YodaCh96/Snake/AP3_Software_04.docx

# Snake The Game

Entwicklung eines Snake-spiels basierend auf Arduino

Verantwortlich: Reindl Dominik, Abreu Diogo, Ioannis Christodoulakis
Arbeitspaket: Software (AP3)
Revision: A
Datum: 28.06.2017
Temperatur: 23.9°C

# 1 Zusammenfassung

In diesem Dokument geht es um das 3. Arbeitspaket des Projektes «Snake the game». Nachdem wir uns schon im «AP-2 Hardware» mit der Software für das Testen der Hardware befasst haben, konnten wir nun das gelernte umsetzen und eine Ausgangslogik schreiben. Die Spiellogik selbst wurde von unserem Informatiker Kollegen, Herr Eggenberger entwickelt. Wir mussten lediglich die Ausgangslogik für das richtige ausschreiben des Arrays übernehmen.

# 2 Ziel des Arbeitspaketes

In diesem Arbeitspaket ist das Ziel, eine funktionsfähige Software zu haben, welche es uns ermöglicht mit unserer Hardware das Spiel «Snake» zu spielen. Dafür müssen wir für die Spiellogik, die von unserem Informatiker Kollegen geschrieben wurde, eine Ausleselogik erstellen welche die Spiellogik auf das von uns gefertigte Shield überträgt.

# 3 Vorstudie

## 3.1 Darstellung auf LED-Matrix korrigiert

### 3.1.1 Problemstellung

Für die Vorstudie haben wir uns damit beschäftigt, eine gleichmässig und korrekt beleuchtete Matrix hinzubekommen. Das Problem war, dass die vorherige Reihenfarbe, aufgrund unserer Testsoftware von AP-2, immer nachleuchten.
Wir haben unser Code welchen wir im AP-2 geschrieben haben, nochmals genau angeschaut, ein Zeitdiagramm geschrieben und folgendes festgestellt.

### 3.1.2 Zeitdiagramm

Nach dem Erstellen eines Zeit Diagramms war uns der Fehler bewusst.

Die roten Markierungen verbinden die zwei Ausgänge ShStPinS und StorePin. Diese müssen zeitgleich ausgegeben werden. Da der erste Ausgang zuständig ist, dass eine neue Zeile angezeigt wird und der zweite Ausgang zuständig für das Ausgeben der neuen 16Bit für die Zeile, müssen diese Zeitgleich von LOW auf HIGH gestellt werden. Es ist sehr wichtig die Zeiten richtig im Griff zu haben. Ist zwischen diesen beiden Befehlen auch nur 1ms Verzögerung, wird auf der vorherigen / nachherigen Reihe die angrenzende Reihe schwach angezeigt.

### 3.1.3 Struktogramme

Bevor wir den neuen Code geschrieben haben, haben wir noch ein Struktogramm geschrieben. Mit diesem ist es ebenfalls einfacher die Übersicht zu behalten.

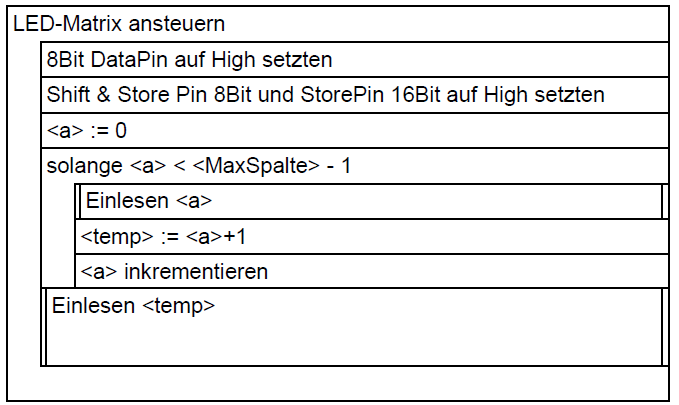
[picture p11: figure]

Dies ist das Haupt Struktogramm für die Ausleselogik

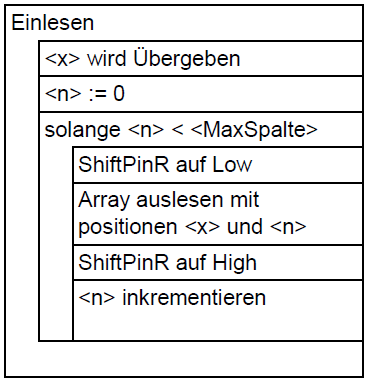
[picture p12: figure]

Hier ist das Struktogramm für das Unterprogramm Einlesen.

### 3.1.4 Lösungsweg

Nach dem wir eine Übersicht geschaffen haben, konnten wir sehen, dass der Fehler beim Ansteuern der beiden Ausgänge StorePin 16Bit und ShStPin 8Bit geschieht. Bei unserer fehlerhaften Programmierung ist eine sehr geringe Zeitverzögerung zwischen der beiden Ausgänge, die eigentlich gleichzeitig auf HIGH wechseln sollten.
Um dieses Problem zu beheben haben wir uns als erstes informiert, wie man bei unserem Zielsystem (Arduino) mehrere Ausgänge gleichzeitig ansteuern kann.
Nach der Recherche haben wir uns für die Portmanipulation entschieden. Dies hat den Vorteil das der Fehler per Software korrigiert werden kann. So muss nichts an der Hardware verändert werden.

Nun haben wir anhand der Struktogramme, Zeitplanung und der Portmanipulation ein neues Programm erstellt.

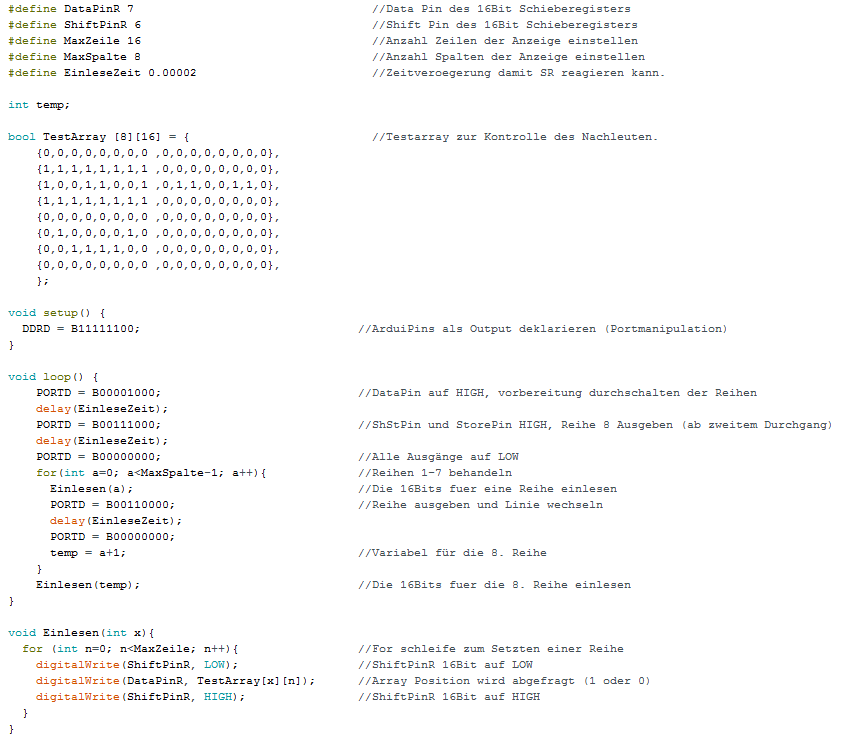
[picture p13: figure]

### 3.1.5 Programmcode

### 3.1.6 Test Darstellung LED-Matrix

Als letztes müssen wir nun unsere Idee, welche wir umgesetzt haben, auch testen. Für den Test haben wir mit Hilfe eines vorgegebenen Arrays ein „Gesicht“ anzeigen lassen.
Das Gesicht hat wie Gewünscht geleuchtet und nun konnte kein Nachleuchten mehr entdeckt werden. Es leuchten auch überall die richtigen LEDs. Somit ist dieses Problem gelöst.

## 3.2 Array umschreiben

### 3.2.1 Problemstellung

Wir haben mit unserem Informatiker folgende Datenstruktur für die Schnittstelle festgelegt. Es handelt sich um ein Array welches eine Grösse von 18 x 10 Felder besitzt. Die äusserste Reihe ist jeweils der Rand. Dieser ist lediglich vorhanden, weil so die Programmierung der Spiellogik einfacher war. Danach kommen immer Grüppchen „R / G“ (rote Markierungen). Eine solche Gruppe repräsentiert ein LED-Slot auf der 8x8 LED Matrix. Das „R“ steht für die rote LED und der Buchstabe „G“ für die grüne LED. Dieses Array wiederspiegelt unsere LED-Matrix 8x8 Grün / Rot.
Mithilfe diesem Array wissen wir welche LEDs auf der Matrix brennen müssen. Unsere Auslese-Logik ist dann in der Lage dieses Array auszulesen und auf die Matrix auf dem Shield zu übertragen.

X | X | X | X | X | X | X | X | X | X | X | X | X | X | X | X | X | X
X | R | G | R | G | R | G | R | G | R | G | R | G | R | G | R | G | X
X | R | G | R | G | R | G | R | G | R | G | R | G | R | G | R | G | X
X | R | G | R | G | R | G | R | G | R | G | R | G | R | G | R | G | X
X | R | G | R | G | R | G | R | G | R | G | R | G | R | G | R | G | X
X | R | G | R | G | R | G | R | G | R | G | R | G | R | G | R | G | X
X | R | G | R | G | R | G | R | G | R | G | R | G | R | G | R | G | X
X | R | G | R | G | R | G | R | G | R | G | R | G | R | G | R | G | X
X | R | G | R | G | R | G | R | G | R | G | R | G | R | G | R | G | X
X | X | X | X | X | X | X | X | X | X | X | X | X | X | X | X | X | x

X = Der Rand des Feldes entspricht einer 0.
R = Die roten LEDs.
G = Die grünen LEDs.

Doch durch unsere Hardware ist es gegeben, dass die ersten 8 Ausgänge für rot und die restlichen 8 Ausgänge für grün sind. Gemäss folgender Darstellung:

R | R | R | R | R | R | R | R | G | G | G | G | G | G | G | G
R | R | R | R | R | R | R | R | G | G | G | G | G | G | G | G
R | R | R | R | R | R | R | R | G | G | G | G | G | G | G | G
R | R | R | R | R | R | R | R | G | G | G | G | G | G | G | G
R | R | R | R | R | R | R | R | G | G | G | G | G | G | G | G
R | R | R | R | R | R | R | R | G | G | G | G | G | G | G | G
R | R | R | R | R | R | R | R | G | G | G | G | G | G | G | G
R | R | R | R | R | R | R | R | G | G | G | G | G | G | G | G

Nun sieht man das eine andere Reihenfolge nötig ist, als wir vom Informatiker bekommen. Somit müssen wir uns überlegen, wie wir diese Differenz beheben.

Grob gesagt gibt es nun zwei Lösungsvarianten. Die eine Variante besteht darin, das Array vom Informatiker auf ein neues Array umzuschreiben und das neue Array dann mit der bestehenden Ausleselogik (vom zweiten Arbeitspaket von der Testfälle) bearbeiten.
Die zweite Variante besteht darin, unsere Ausleselogik so anzupassen, dass das Array vom Informatiker nicht in der Reihenfolge, sondern gleich so ausliest, dass zuerst die Daten ausgelesen werden welche benötigt sind. Also zuerst die acht Bit der roten Farbe danach die acht Bit der grünen.

### 3.2.2 Entscheidung

Bei uns ist es wichtig, dass es möglichst wenig Zeit beansprucht für unsere Ausleselogik, da eine schöne Darstellung auf der LED Anzeige eine schnelle Durchlaufzeit voraussetzt. Daher ist die zweite Variante sinnvoller. Somit wollen wir in unserem Code möglichst wenige Schritte machen müssen. Deshalb ist es effizienter das vorhandene Array nach der Reihenfolge welche wir die Bits brauchen auszulesen.

### 3.2.3 Struktogramm

Da wir wissen, wie unsere Ausgangslogik nun funktionieren muss, haben wir den Umständen entsprechend ein neues Struktogramm erstellt.

Als erstes ist hier das Haupt-Struktogramm ersichtlich. Mit dieser Logik kann das 10 x 18 Array von unserem Informatiker ausgelesen und die Informationen auf die LED-Matrix übertragen werden.

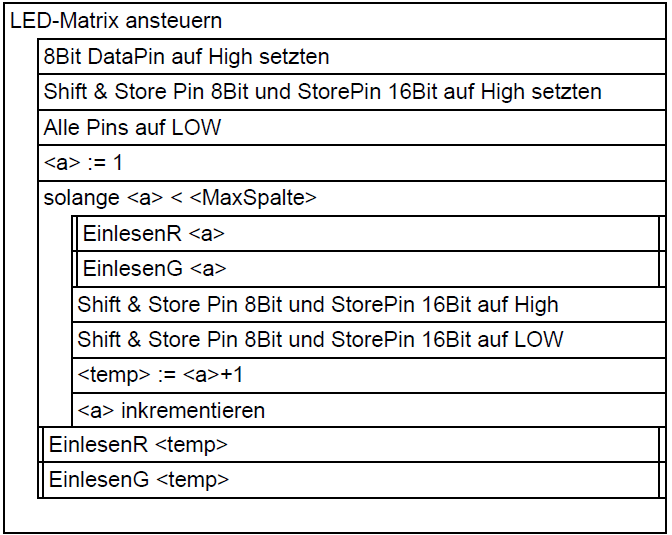
[picture p14: figure]

Hier sind noch die Unterprogramme aufgelistet:

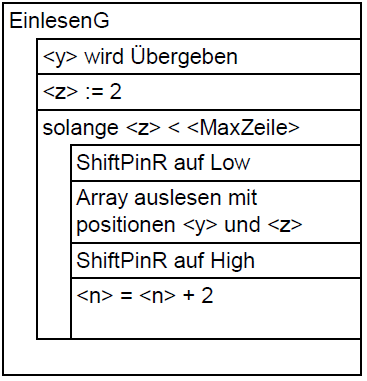
[picture p15: figure]
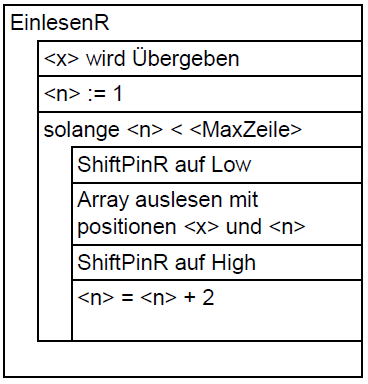
[picture p16: figure]

### 3.2.4 Programmcode

Da wir die Struktogramme erstellt haben, kann nun ein Programm geschrieben werden, welches den neuen Anforderungen entspricht.

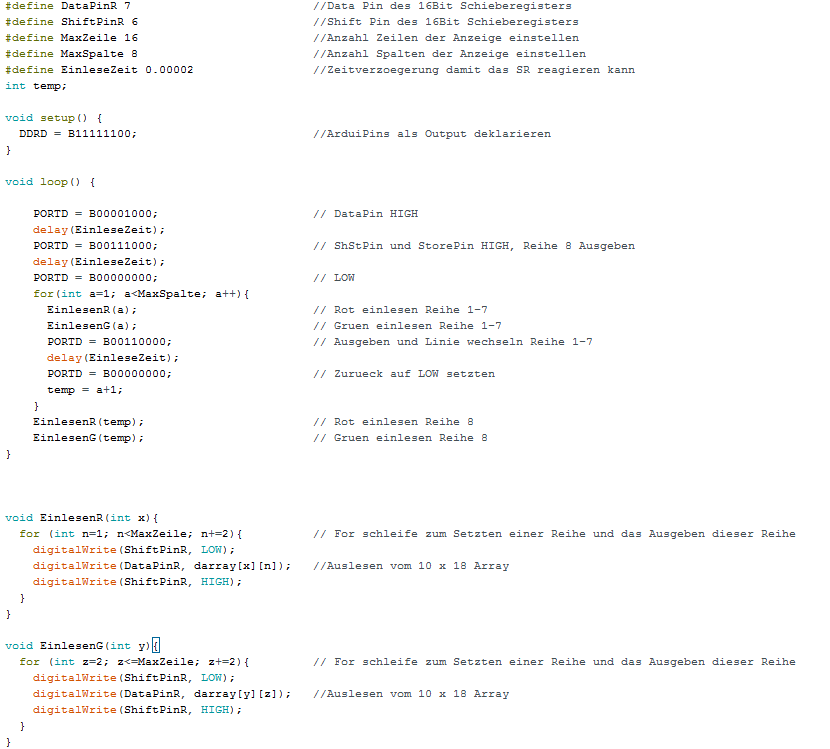
[picture p17: figure]

### 3.2.5 Test Auslesen und Ausgeben von 10 x 18 Array

Für unseren Test haben wir selbst einen 10 x 18 Array erstellt und diesen ausgelesen. Wir haben kontrolliert ob, auf der LED-Matrix ebenfalls das Bild wiedergegeben wird, wie wir es erwarten.
Zu diesem Zweck haben wir je eine Zeile rot und dann eine Zeile grün leuchten lassen und dies über alle Zeilen hinweg.

Als wir das Programm zusammen mit dem Array auf das Arduino geladen haben, konnten wir wie erwartet das gewünschte Muster auf der LED-Anzeige sehen.

Unsere Lösung ist somit funktionsfähig.

# 4 Spiellogik und Ausleselogik zusammenfügen

Wir haben jetzt all unsere Teilprobleme gelöst und können unsere Lösung als Ausleselogik mit der Spiellogik vom Informatiker zusammenfügen.

Da wir selbst im Programmieren erst die Grundkenntnisse beherrschen, haben wir diesen Schritt gleich mit dem Informatiker, Herr Eggenberger, durchgeführt.

## 4.1 Gesamttest Nummer 1

Wir testen die am Anfang definierten Testfälle durch

Testfall | Tatsächliche Reaktion | Ok?
Das Spiel muss am Schluss von unserem Projekt, auf einer 8x8 Matrix mit vier Taster spielbar sein (gemäss Spieldefinition). | Es ist nicht spielbar. Die Spiel und Ausleselogik arbeiten nicht sauber Zusammen | Nein

Da der erste Testfall bereits nicht geklappt hat, müssen die nächsten nicht getestet werden. Als nächstes werden wir den Fehler suchen.

## 4.2 Problematik

Wir analysierten zusammen das Problem, um herauszufinden warum das auf der Anzeige meist ein kurioses Muster angezeigt wird. Beim genaueren Betrachten haben wir einen grundlegenden Fehler entdeckt.
Wir haben ein konzeptionelles Problem. Unsere Hardware ist darauf ausgelegt, dass diese ohne Unterbruch angesteuert wird. Das heisst, dass die Bits für die Darstellung ständig neu übertragen werden müssen. Wir steuern auf einmal immer nur eine Reihe an und schalten dann in hoher Geschwindigkeit die einzelnen acht Reihen um. Dieser Vorgang muss mindestens 20 mal in der Sekunde geschehen damit auf der LED Matrix ein konstantes Bild angezeigt wird.
Das Problem lag nun genau darin, dass von der Spiellogik her unsere Ausleselogik mehrmals aufgerufen wird, aber zwischen den Aufrufen wird die Ausleselogik unterbrochen. So konnte kein schönes Bild dargestellt werden.

## 4.3 Anpassung

Die erste Konsequenz daraus ist, dass der Informatiker, Herr Eggenberger, die Spiellogik umschreibt. Der Code muss die Spiellogik und die Ausleselogik parallel laufen lassen können. Bei diesem Punkt können wir nicht viel mitwirken, da dies unsere Programmierkenntnisse übersteigert. Und das Problem besteht auf Seite der Spiellogik, welche wir nicht erstellt haben.

## 4.4 Spiellogik vom Informatiker

Hier sehen Sie eine Übersicht wie die Spiellogik vom Informatiker aufgebaut ist. Der Gesamtcode ist unter „H:\LL\ELO 2016\Snake_Codes“ zu finden.

## 4.5 Gesamttest Nummer 2

Nun können wir unsere Testfälle nochmal durchgehen.

Testfall | Tatsächliche Reaktion | Ok?
Das Spiel muss am Schluss von unserem Projekt, auf einer 8x8 Matrix mit vier Taster spielbar sein (gemäss Spieldefinition). | Wie erwartet: Schlange steuerbar, Futter essbar, Rand und eigener Schwanz führt zur Niederlage. Punktestand wird angezeigt. | Ok
Falls mehrere Taster auf einmal gedrückt und gehalten werden, soll der letzte gelesene Impuls übernommen werden. | Wir erwartet | Ok
Wenn man nur kurz und ausserhalb von Takt der Schlangenbewegung den Taster betätigt, soll es diese Tasterrichtung speichern und zum Takt ausführen. | Wie erwartet | Ok
Beim Betätigen von mehreren Tastern nacheinander, ausserhalb des Taktes der Schlangenbewegung, soll es den letzten eingegangener Taster Impuls übernehmen. | Wie erwartet | Ok
Falls eine in entgegen gesetzter Richtungstaste geklickt wird (in Bezug auf die Schlangenbewegung), soll es keine Richtungsänderung geben. | Wie erwartet | Ok

# 5 Auswertung

Wir konnten all unsere Einzellösungen realisieren und erfolgreich testen. Die grosse Problematik hatten wir beim Zusammenführen der einzelnen Teillösungen, vor allem mit dem Zusammenführen der Ausleselogik mit der Spielelogik des Informatikers. Da unsere Ausgangslogik ununterbrochen laufen muss, musste der Informatiker eine Lösung finden, damit die Spielelogik mit der Ausleselogik parallel abläuft. Diese Problematik kam davon, dass wir die Schnittstellen zu Beginn des Projekts nicht sauber genug definiert und kommuniziert haben. Die Konsequenz war zwar nicht so schlimm, da der Informatiker eine Lösung gefunden hat. Jedoch hat dieser Fehler unsere Zeitplanung durcheinandergebracht. Wir haben noch Reserven eingebplant, welche dann zur Gesamt Fertigstellung gebraucht werden.

In diesem Arbeitspaket konnten wir viel Wissen über das Programmieren sammeln und selbst erfahren wie wichtig die Definition der Schnittstellen von Beginn an sind.

Auch wenn wir für dieses Arbeitspaket Zeitlich länger gebraucht haben, konnten wir das Projekt wie gewünscht abschliessen. Wir haben ein funktionsfähiges Snake geplant, entwickelt und gefertigt.

# 6 Anhang

## 6.1 Glossar

Arduino / Arduino-Board
Handelsware: Eine bestückte Leiterplatine mit mehreren Schnittstellen (Ein und Ausgänge). Diese kann beliebig via Computer programmiert werden, um flexibel Codes ausführen zu können

Shield
Ein Aufbau auf einer Platine, welche alle nötigen Hardware besitzt. Dies kann als fertiges Element direkt (zum Beispiel bei einem Arduino) aufgesetzt werden.

LED-Slot
Die LED Matrix besteht aus 8 x 8 LED Slots. Also 64 Stück. Jeder dieser Slot besteht aus einem grünen und einem rotem LED.

LED-Matrix
Unsere Anzeige, welche aus 8 x 8 LED Slots besteht.

Portmanipulation
Eine Programmier-Methode beim Arduino. Mit diesen Befehlen können ganze Ports (Gruppen von digitalen / analogen Ein- Ausgänge) angesprochen werden. So können sehr viel genauer und Zeitgleicher Ausgänge angesteuert werden.

# 7 Identifikation

Ort, Datum: Unterschriften:

_________________ _________________ _________________

Diogo Abreu Dominik Reindl

D.R. / D.A. Seite 12 von 12
