YodaCh96/Snake/AP-3 Software/AP3_Software.docx

# Snake The Game

Entwicklung eines Snake-spiels basierend auf Arduino

Verantwortlich: Reindl Dominik, Abreu Diogo, Ioannis Christodoulakis
Arbeitspaket: Software (AP3)
Revision: A
Datum: 30.05.2017
Temperatur: 23.9°C

# 1 Zusammenfassung

In diesem Dokument geht es um das 3. Arbeitspaket des Projektes «Snake the game». Nachdem wir uns schon im «AP-2 Hardware» mit der Software für das Testen der Hardware befasst haben, konnten wir nun das gelernte umsetzen und eine Ausgangslogik schreiben. Die Spiellogik selbst wurde von unserem Informatiker Kollegen, Herr Eggenberger entwickelt, wir mussten nur noch die Ausgangslogik für das richtige ausschreiben des Arrays übernehmen.

# 2 Ziel des Arbeitspaketes

In diesem Arbeitspaket ist das Ziel, eine funktionsfähige Software zu haben, welche es uns ermöglicht mit unserer Hardware das Spiel «Snake» zu spielen. Dafür müssen wir für die Spiellogik, die von unserem Informatiker Kollegen geschrieben wurde, eine Ausgangslogik erstellen welche die Spiellogik auf unser Shield überträgt.

# 3 Vorstudie

## 3.1 Darstellung auf LED-Matrix korrigiert

### 3.1.1 Problemstellung

Für die Vorstudie haben wir uns damit beschäftigt, eine gleichmässig beleuchtete Matrix hinzubekommen. Das Problem war, dass die vorherige Reihenfarbe, aufgrund unserer Methode für die Beschaltung der einzelnen Reihen, immer nachleuchten.
Wir haben unser Code welchen wir im Arbeitspaket 2 geschrieben haben nochmals genau angeschaut.

### 3.1.2 Zeitdiagramm

Nach dem Erstellen eines Zeit Diagramms war uns der Fehler bewusst.

Die roten Markierungen verbinden die zwei Ausgänge ShStPinS und StorePin. Diese müssen zeitgleich ausgegeben werden. Da der erste Ausgang zuständig ist, dass eine neue Reihe angezeigt wird und der zweite Ausgang zuständig für das Ausgeben der neuen 16Bit für die Reihe, müssen diese Zeitgleich von LOW auf HIGH gestellt werden. Ist zwischen diesen beiden Befehlen auch nur 1ms Verzögerung, wird auf der vorherigen / nachherigen Reihe die angrenzende Reihe schwach angezeigt.

### 3.1.3 Struktogramme

Bevor wir den neuen Code geschrieben haben, haben wir noch ein Struktogramm geschrieben. Mit diesem ist es ebenfalls einfach die Übersicht zu behalten.


Dies ist das Haupt Struktogramm für die Ausleselogik


Hier ist das Struktogramm für das Unterprogramm Einlesen.

### 3.1.4 Lösungsweg

Nach dem wir eine Übersicht geschaffen haben, konnten wir sehen, dass der Fehler beim Ansteuern der beiden Ausgänge StorePin 16Bit und ShStPin 8Bit geschieht. Da wir bei unserer momentanen Programmierung eine sehr geringe Zeitverzögerung zwischen dem HIGH stellen der beiden Ausgänge haben.
Um dieses Problem zu beheben haben wir uns als erstes Informiert wie man bei unserem Zielsystem (Arduino) mehrere Ausgänge gleichzeitig ansteuern kann.
Nach der Recherche haben wir uns für die Port-Manipulation entschieden. Dies hat den Vorteil das der Fehler per Software korrigiert werden kann. So muss nichts an der Hardware verändert werden.

Nun haben wir anhand der Struktogramme, Zeitplanung und der Portmanipulation ein neues Programm erstellt.


### 3.1.5 Programmcode

### 3.1.6 Test Darstellung LED-Matrix

Als letztes müssen wir unsere Idee, welche wir umgesetzt haben, testen. Für den Test haben wir ein „Gesicht“ anzeigen lassen. Nun konnte kein Nachleuchten mehr entdeckt werden. Es leuchten auch überall die richtigen LEDs. Somit ist dieses Problem gelöst.

## 3.2 Array umschreiben

### 3.2.1 Problemstellung

Wir haben mit unserem Informatiker folgende Datenstruktur für die Schnittstelle festgelegt. Es handelt sich um ein Array welches eine Grösse von 18 x 10 Felder besitzt. Die Äusserste Reihe ist jeweils der Rand. Dieser ist lediglich vorhanden, weil so die Programmierung der Spiellogik einfach war. Danach kommen immer Grüppchen „R / G“ (rote Markierungen). Eine solche Gruppe repräsentiert ein LED-Slot auf der 8x8 LED Matrix. Das „R“ steht für das rote LED und der Buchstabe „G“ für das grüne LED. Dieses Array wiederspiegelt unsere LED-Matrix 8x8 Grün / Rot.
Mithilfe diesem Array wissen wir welche LEDs auf der Matrix brennen müssen. Unsere Auslese-Logik ist dann in der Lage dieses Array auszulesen und auf die Matrix zu übertragen.

X | X | X | X | X | X | X | X | X | X | X | X | X | X | X | X | X | X
X | R | G | R | G | R | G | R | G | R | G | R | G | R | G | R | G | X
X | R | G | R | G | R | G | R | G | R | G | R | G | R | G | R | G | X
X | R | G | R | G | R | G | R | G | R | G | R | G | R | G | R | G | X
X | R | G | R | G | R | G | R | G | R | G | R | G | R | G | R | G | X
X | R | G | R | G | R | G | R | G | R | G | R | G | R | G | R | G | X
X | R | G | R | G | R | G | R | G | R | G | R | G | R | G | R | G | X
X | R | G | R | G | R | G | R | G | R | G | R | G | R | G | R | G | X
X | R | G | R | G | R | G | R | G | R | G | R | G | R | G | R | G | X
X | X | X | X | X | X | X | X | X | X | X | X | X | X | X | X | X | x

X = Der Rand des Feldes entspricht einer 0.
R = Die roten LEDs.
G = Die grünen LEDs.

Doch durch unsere Hardware ist es gegeben, dass die ersten 8 Ausgänge für rot und die restlichen 8 Ausgänge für grün sind. Gemäss folgender Darstellung.

R | R | R | R | R | R | R | R | G | G | G | G | G | G | G | G
R | R | R | R | R | R | R | R | G | G | G | G | G | G | G | G
R | R | R | R | R | R | R | R | G | G | G | G | G | G | G | G
R | R | R | R | R | R | R | R | G | G | G | G | G | G | G | G
R | R | R | R | R | R | R | R | G | G | G | G | G | G | G | G
R | R | R | R | R | R | R | R | G | G | G | G | G | G | G | G
R | R | R | R | R | R | R | R | G | G | G | G | G | G | G | G
R | R | R | R | R | R | R | R | G | G | G | G | G | G | G | G

Nun sieht man das eine andere Reihenfolge nötig ist, als wir vom Informatiker bekommen. Somit müssen wir uns überlegen, wie wir diese Differenz beheben.

Grob gesagt gibt es nun zwei Lösungsvarianten. Die eine Variante besteht darin das Array vom Informatiker umzuschreiben auf ein neues Array und das neue Array dann mit der bestehenden Ausleselogik (Vom zweiten Arbeitspaket von der Testfälle) bearbeiten.
Die Zweite Variante besteht darin, unsere Ausleselogik so anzupassen dass das Array vom Informatiker nicht in der Reihenfolge sondern gleich so ausliest das zuerst die Daten ausgelesen werden welche benötigt sind. Also zuerst die acht Bit der roten Farbe danach die acht Bit der grünen.

### 3.2.2 Entscheidung

Bei uns ist es wichtig das es möglichst wenig Zeit beansprucht für unsere Ausleselogik. Da eine schöne Darstellung auf der LED Anzeige eine schnelle Durchlaufzeit voraussetzt, wollen wir möglichst wenig Schritte machen müssen in unserem Code. So ist es effizienter das Vorhandene Array nach der Reihenfolge welche wir die Bits brauchen auszulesen. So ist ein schreiben und dann wieder auslesen von einem neuen Array verhindert. Der Zugriff auf Array ist eine im Vergleich zeitaufwändige Option.

### 3.2.3 Struktogramm

So haben wir zu den Umständen entsprechend ein neues Struktogramm erstellt. Da wir wissen, wie unsere Ausgangslogik nun funktionieren muss.

Als erstes hier das Haupt-Struktogramm. Mit dieser Logik kann das 10 x 18 Array von unserem Informatiker ausgelesen und die Informationen auf die LED-Matrix übertragen werden.


Hier sind noch die Unterprogramme aufgelistet:


### 3.2.4 Programmcode

Da wir die Struktogramme erstellt haben, kann nun ein Programm geschrieben werden, welches den neuen Anforderungen entspricht.

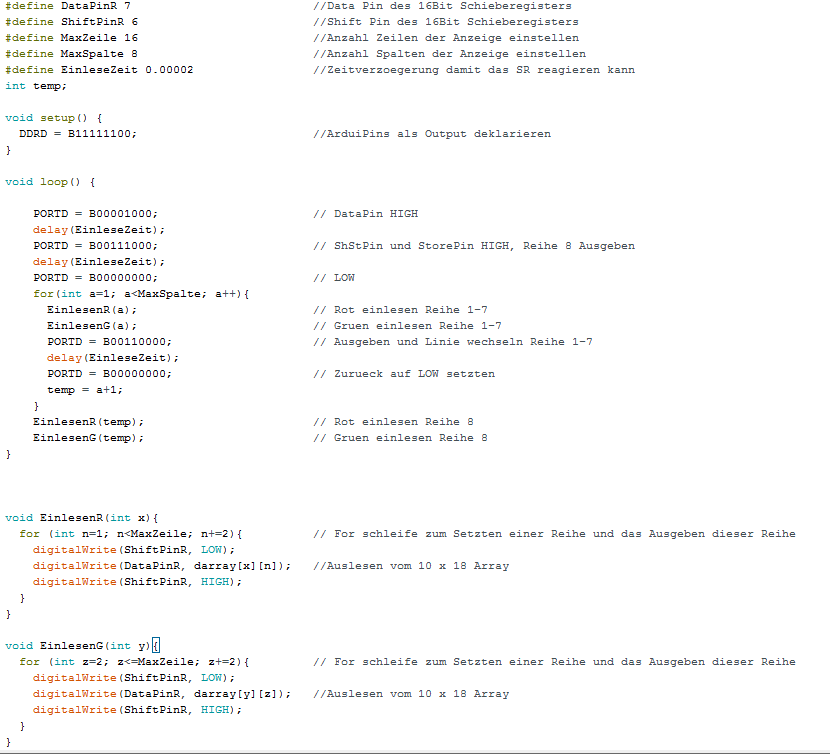
[picture p18: figure]

### 3.2.5 Test Auslesen und Ausgeben von 10 x 18 Array

Für unseren Test haben wir selbst eine 10 x 18 Array erstellt und dieses ausgelesen. Wir haben kontrolliert ob, auf der LED-Matrix ebenfalls das Bild wiedergegeben wird, wie wir es erwarten.
Zu diesem Zweck haben wir je eine Zeile rot und dann eine Zeile grün leuchten lassen und dies über alle Zeilen hinweg.

Als wir das Programm zusammen mit dem Array auf das Arduino geladen haben, konnten wir wie erwartet das gewünschte Muster auf der LED-Anzeige sehen.

Unsere Lösung ist somit funktionsfähig.

# 4 Spiellogik und Ausleselogik zusammenfügen

# 5 Test des Snake-Spiels

Testfälle vom Anfang des Projektes anschauen

## 5.1 Testfälle

Testschritt | Erwartete Reaktion | Tatsächliche Reaktion | Wunsch / Pflicht
Programmcode für LED durchlaufen lassen. | Eine LED Reihe nach der anderen sollten anfangen zu leuchten und wieder ausgehen. | Es leuchten keine LEDs. | Pflicht
Taster-Funktionen testen: Alle vier Tasten werden einzeln durchgeklickt. | Bei jeder Taster muss ein anderes Muster auf der LED Anzeige aufleuchten. | Die Taster ergeben keine Reaktion. | Pflicht
Gibt es einen Piezo Buzzer für Soundeffekte, sowie ein Potentiometer (Poti) für die Lautstärke? | Beim Testen gibt es Töne von unsere Shield aus. Die Lautstärke ist einstellbar mit einem Poti. | Dieses Wunschziel haben wir aus Zeitgründen nicht erreicht. | Wunsch
Wurde ein Gehäuse definiert für unsere Hardware? | Als Ergebnis haben wir einen Plan von einem Gehäuse. | Dieses Wunschziel haben wir aus Zeitgründen nicht erreicht. | Wunsch

# 6 Korrekturen

## 6.1 Fehlersuche

Leider konnten wir nicht unser gewünschtes Ergebnis auf Anhieb erreichen. Nun müssen wir Systematisch den Fehler herausfinden.

Unsere erste Überlegung war, ob der Fehler auf Seite der Software oder Hardware liegt. Bei der Software konnten wir schnell mithilfe der «Serial» Funktion von Arduino herausfinden das die Software wie gewünscht durchläuft.

Deswegen haben wir als nächstes unser Shield genauer angeschaut. Hier haben wir die einzelnen Komponenten durchgetestet. Dafür haben wir mit der LED-Matrix angefangen. Dies erschien uns ein guter Anfang, da überhaupt kein LED geleuchtet hat. Wir haben mithilfe eines Speisegerät und einem Vorwiderstand die LEDs manuell einzeln Angesteuert. Da haben wir festgestellt das die Anode und Katode vertauscht sind. Somit wurden bei unserem Aufbau alle LEDs auf der Matrix in Sperrrichtung betrieben. Der Fehler schlich sich ein, da wir unseren Fokus viel zu wenig darauf hatten, dass es von diesem LED Matrix mit «Reihe Kathode» sowie «Reihe Anode» Ausführung gibt. So ist es gekommen, dass wir das Datenblatt mit «Reihe Kathode» beim Erstellen der Shield hatten. Doch die Überlegung unseren Shield haben wir auf der «Reihe Anode» aufgebaut.
Bei der Vorstudie wurde diese Problematik leider zu wenig genau dokumentiert.

## 6.2 Entscheid Korrekturen

## 6.3 Programmcode

## 6.4 Test des Snake-Spiels

# 7 Auswertung

Beim zweiten Durchgang konnten wie in unseren Zielen definiert, ein funktionsfähiges Shield herstellen. Wir haben dieses Arbeitspaket vorgezogen. Da Herr Eggenberger (Informatik-Ressource) mit der Spiellogik in Verzug kam. Für das Arbeitspaket Software bräuchten wir jedoch die Software von Herr Eggenberger.

Wir haben nicht von Anfang an sauber den Tatbestand dokumentiert und aufgezeigt. So kam es in diesem Arbeitspaket zu einem Fehler, welcher dazu führte, dass wir unser Shield ein zweites Mal löten mussten. So sind wir in unserem Zeitplan in den Verzug gekommen. Wir konnten so ebenfalls nur die Pflichtziele erfüllen. Falls zum Schluss beim Arbeitspaket «Endprodukt» genug Zeit für Verbesserungen bleibt, werden wir noch die Wunschziele einfügen.

Nach dem zweiten Testlauf haben wir bemerkt, dass bei der Anzeige auf dem Display einige LED Punkte nicht sauber angesteuert werden. Doch wir konnten ausschliessen, dass es von der Hardware aus kommt. So werden wir beim AP Software für dieses Problem noch eine Vorstudie durchführen.

# 8 Anhang

## 8.1 Glossar

Arduino / Arduino-Board
Handelsware: Eine bestückte Leiterplatine mit mehreren Schnittstellen (Ein und Ausgänge). Diese kann beliebig via Computer programmiert werden, um flexibel Codes ausführen zu können

Shield
Ein Aufbau auf einer Platine, welche alle nötigen Hardware besitzt. Dies kann als fertiges Element direkt (zum Beispiel bei einem Arduino) aufgesetzt werden.

Bedienelemente
Komponenten, welche effektiv zum Spielen benötigt werden. Dazu gehören LED Matrix, Bedientaster sowie der Ein- / Austaster.

Serial
Dies ist eine Funktion beim Arduino. Mit diesem Befehl kann in einem Fenster im Computer je nach Arbeitsschritt andere Texte / Werte anzeigen lassen. Dies ist sehr nützlich um die Funktionsfähigkeit einer Software zu überprüfen.

LED-Slot
Die LED Matrix besteht aus 8 x 8 LED Slots. Also 64 Stück. Jeder dieser Slot besteht aus einem grünen und rotem LED.

## 8.2 Datenblätter

## 8.3 Programmcode

# 9 Identifikation

Ort, Datum: Unterschriften:

_________________ _________________ _________________

Diogo Abreu Dominik Reindl

D.R. / D.A. Seite 6 von 13
