YodaCh96/Snake/LED Matrix Schema.docx

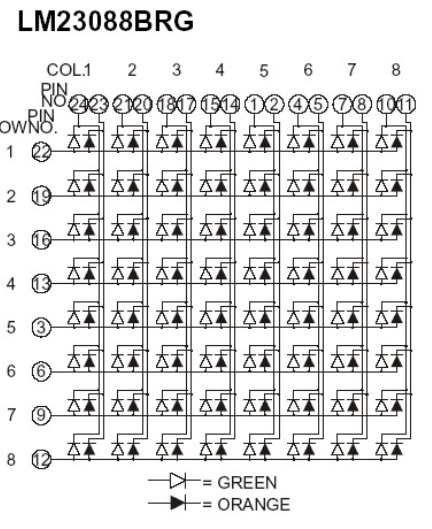
[picture p25: figure]
