YodaCh96/Snake/AP-1 Konzept/Schema_Schnittstellen.docx

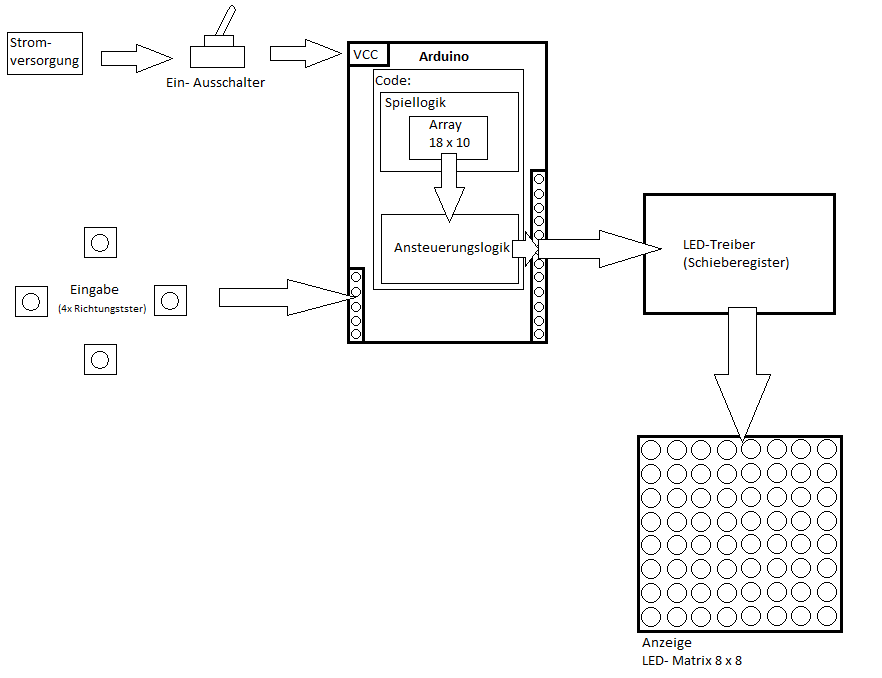
[picture p26: figure]

4 x Richtungstaster
