YodaCh96/Snake/Administration/Projekt Status report.pdf

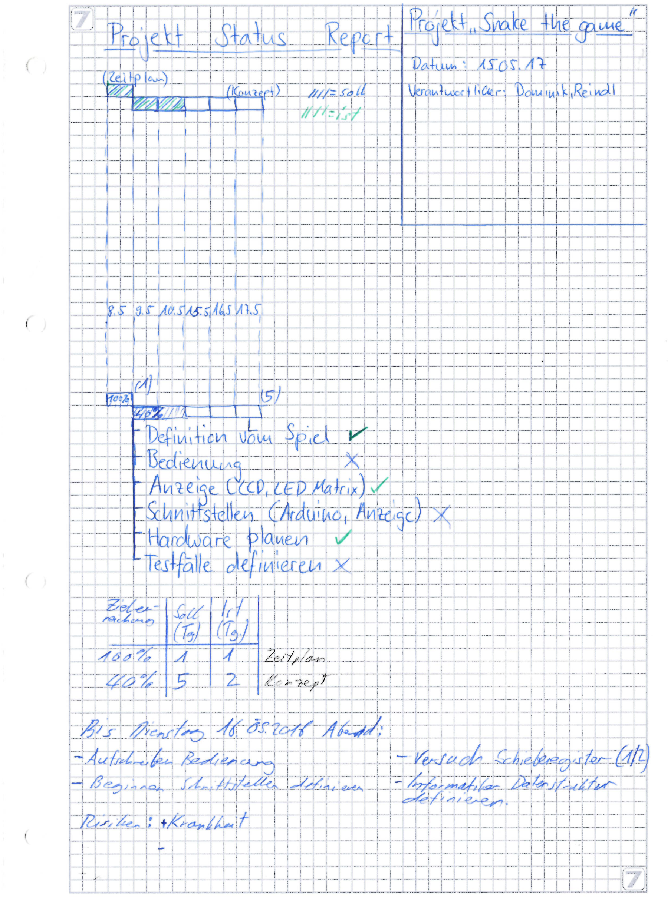
[picture p27: page 1]
