YodaCh96/Snake/AP-1 Konzept/Datenstruktur.pdf

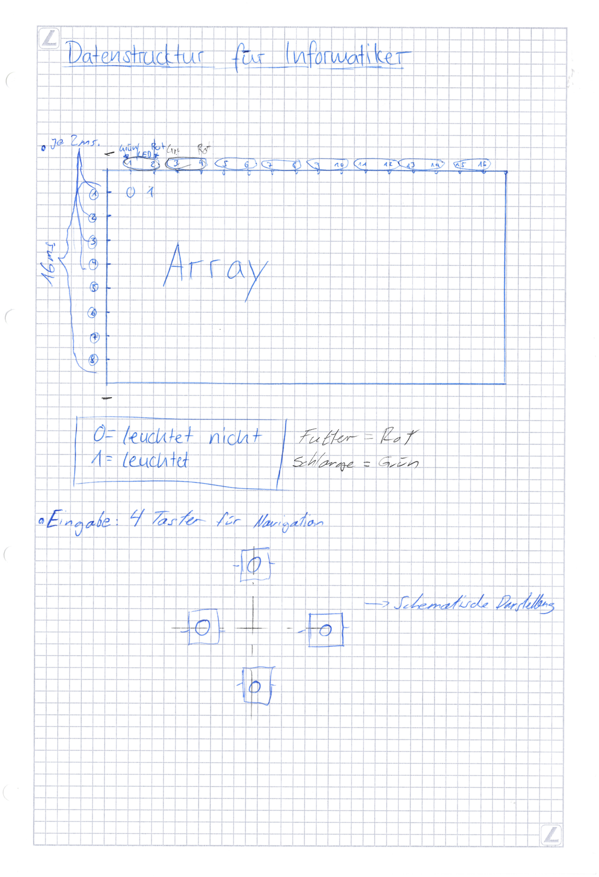
[picture p28: page 1]
