YodaCh96/Snake/AP-1 Konzept/Zeichnung Lochrasterplatine.pdf

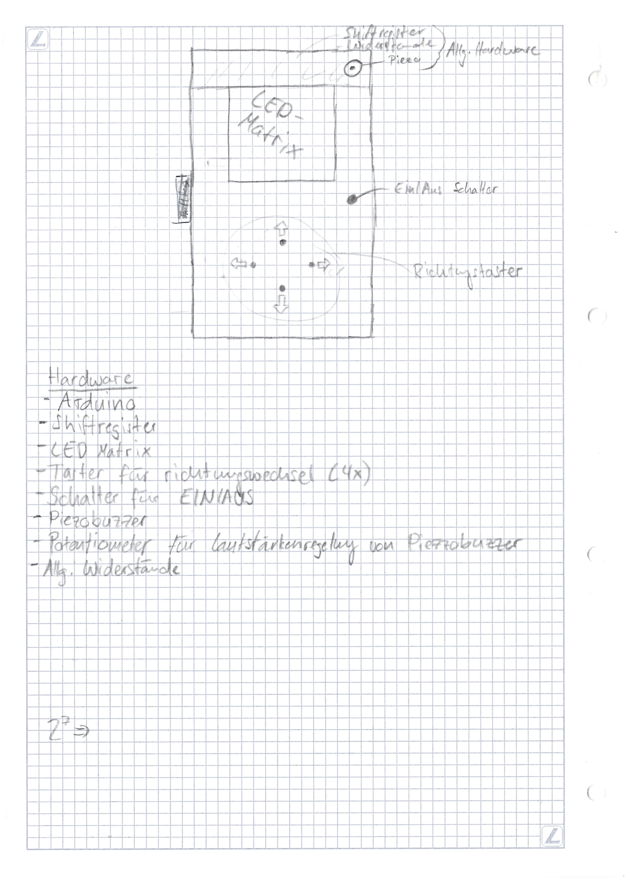
[picture p29: page 1]
