YodaCh96/Snake/AP-2 HW/Bestueckungsplan_V2.pdf

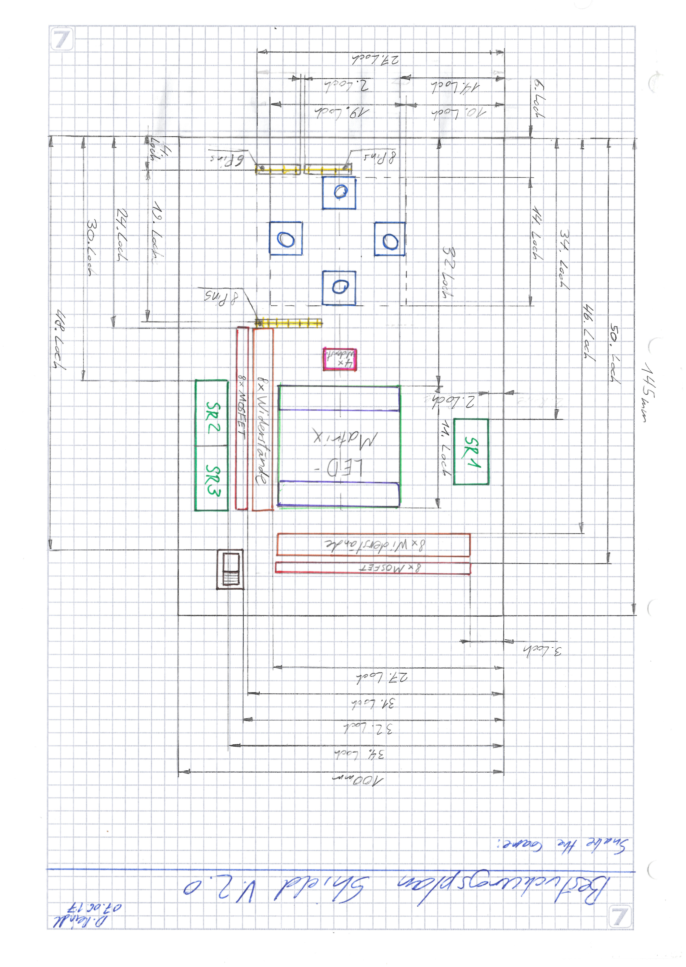
[picture p30: page 1]
