YodaCh96/Snake/AP-2 HW/Farben.pdf

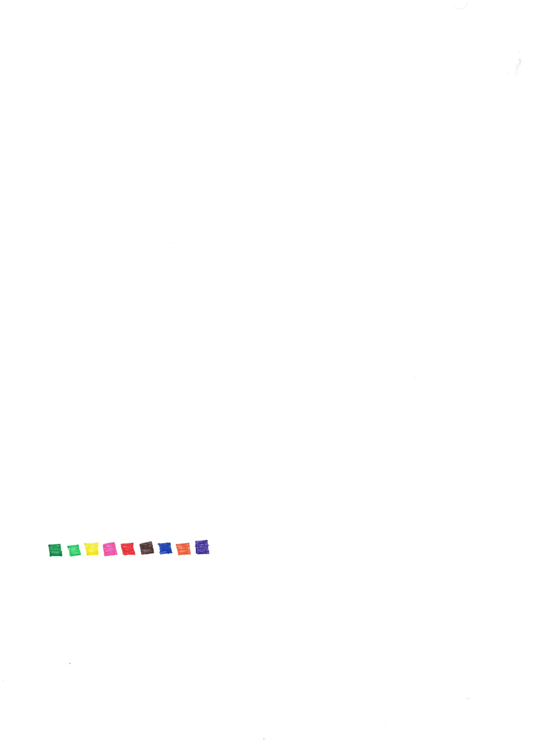
[picture p31: page 1]
