YodaCh96/Snake/AP-2 HW/PR-PE-01-Farb-PDF-20170523.pdf

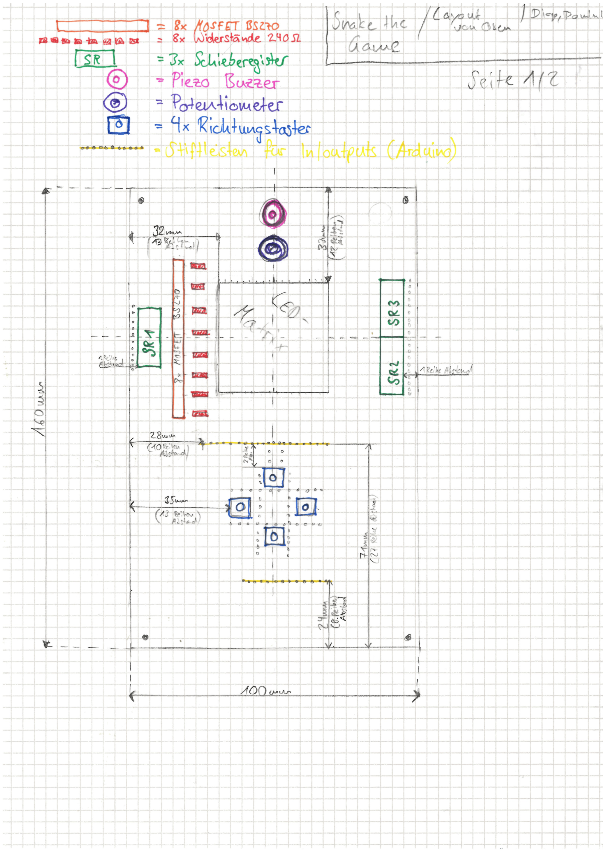
[picture p32: page 1]
