YodaCh96/Snake/AP-2 HW/PR-PE-01-Farb-PDF-20170523_2017052315203700.pdf

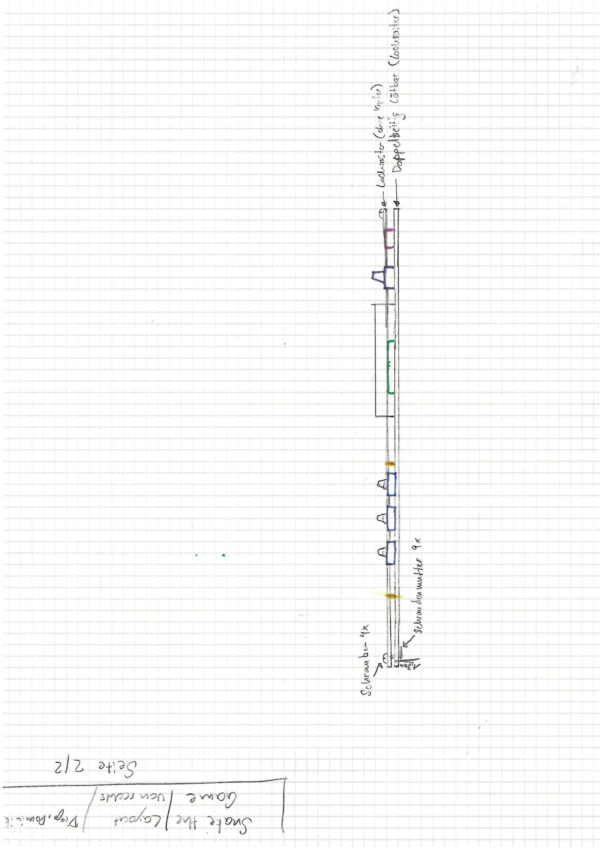
[picture p33: page 1]
