YodaCh96/Snake/AP-2 HW/PR-PE-01-Farb-PDF-20170523_2017052315213200.pdf

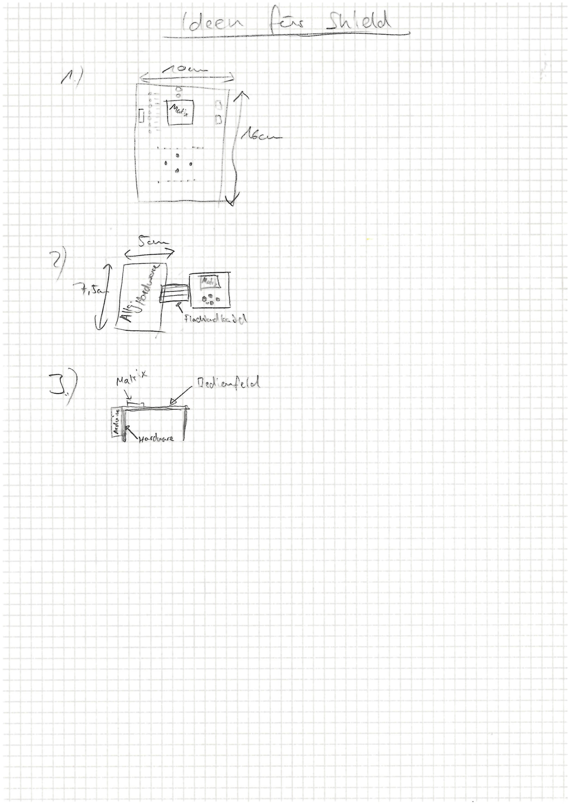
[picture p34: page 1]
