YodaCh96/Snake/AP-2 HW/PR-PE-01-Farb-PDF-20170523_2017052315221900.pdf

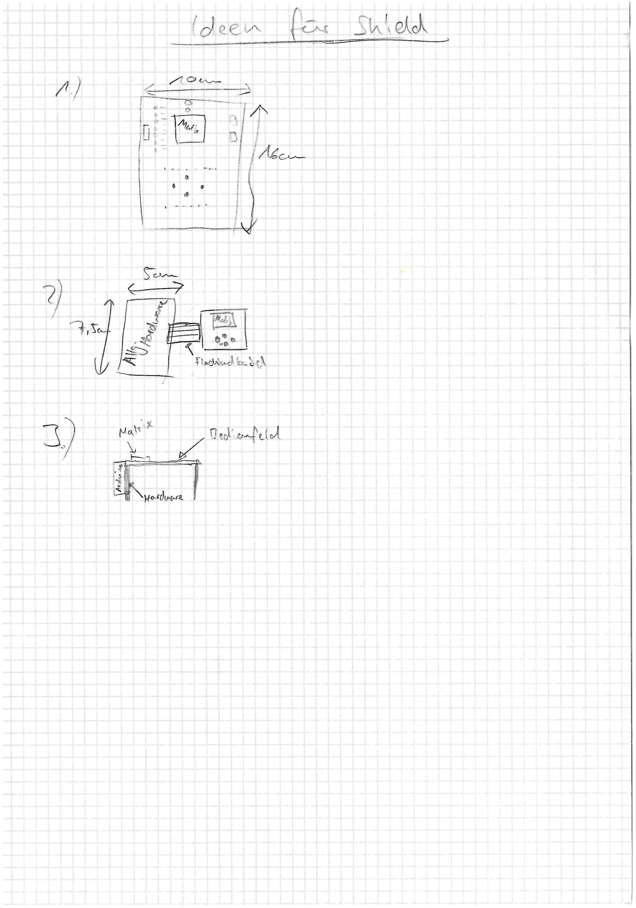
[picture p35: page 1]
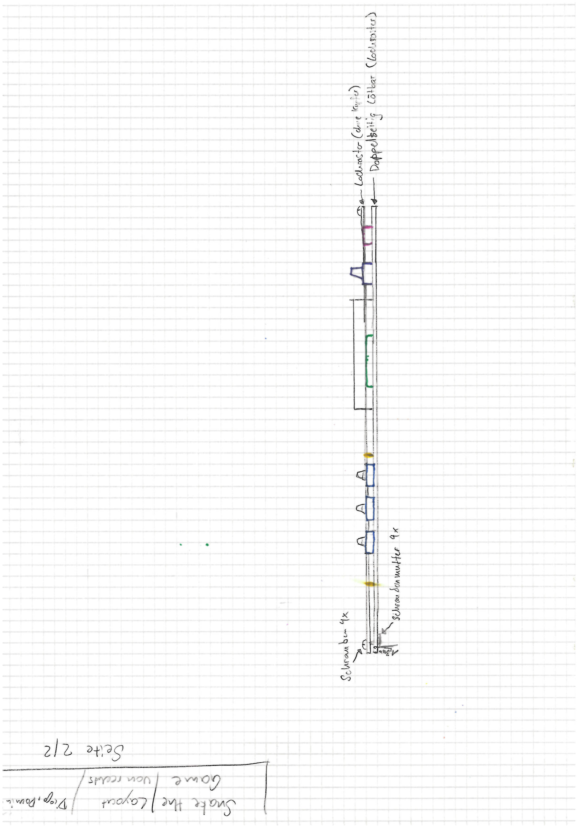
[picture p36: page 2]
