YodaCh96/Snake/AP-3 Software/Zeitplan.pdf

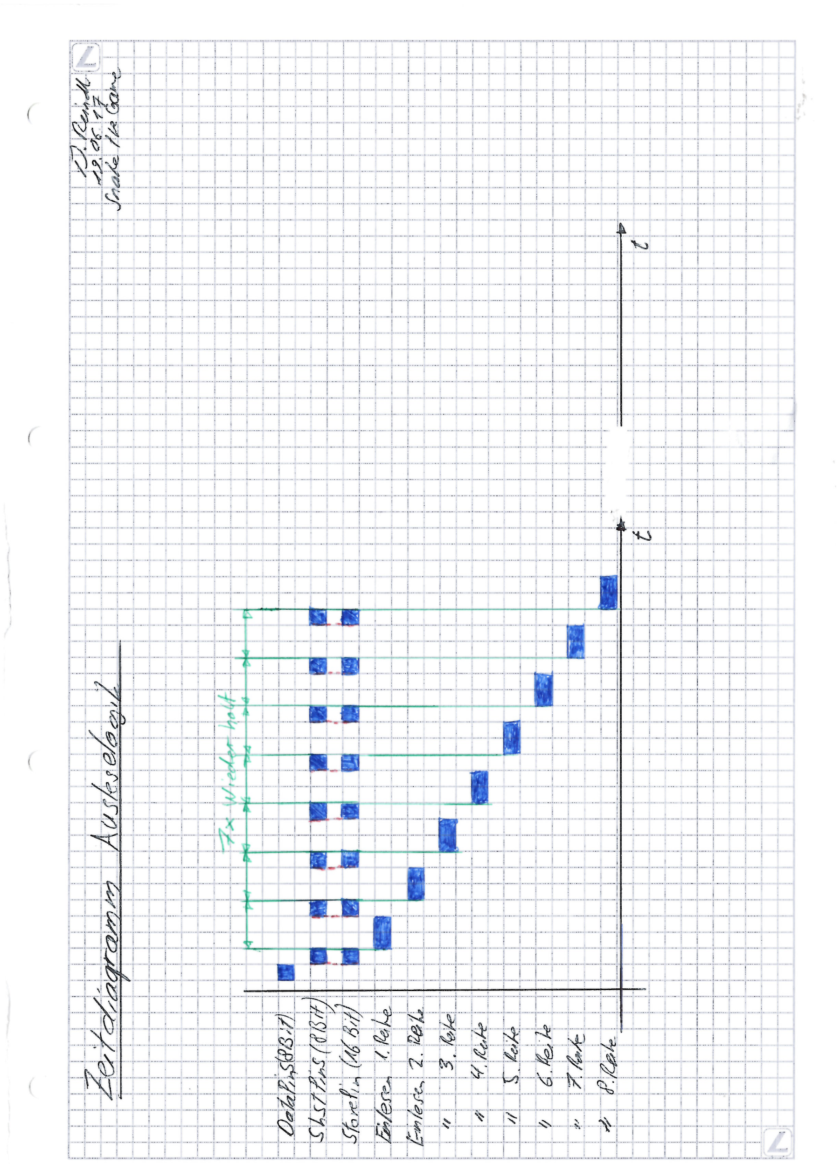
[picture p37: page 1]
