YodaCh96/Snake/Bilder/Anzeige.jpg

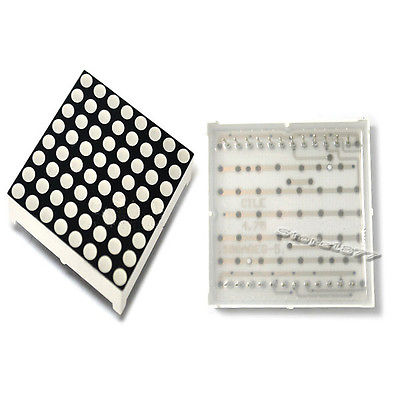
Bilder/Anzeige.jpg
