YodaCh96/Snake/Bilder/SchnittstellenKonzept.png

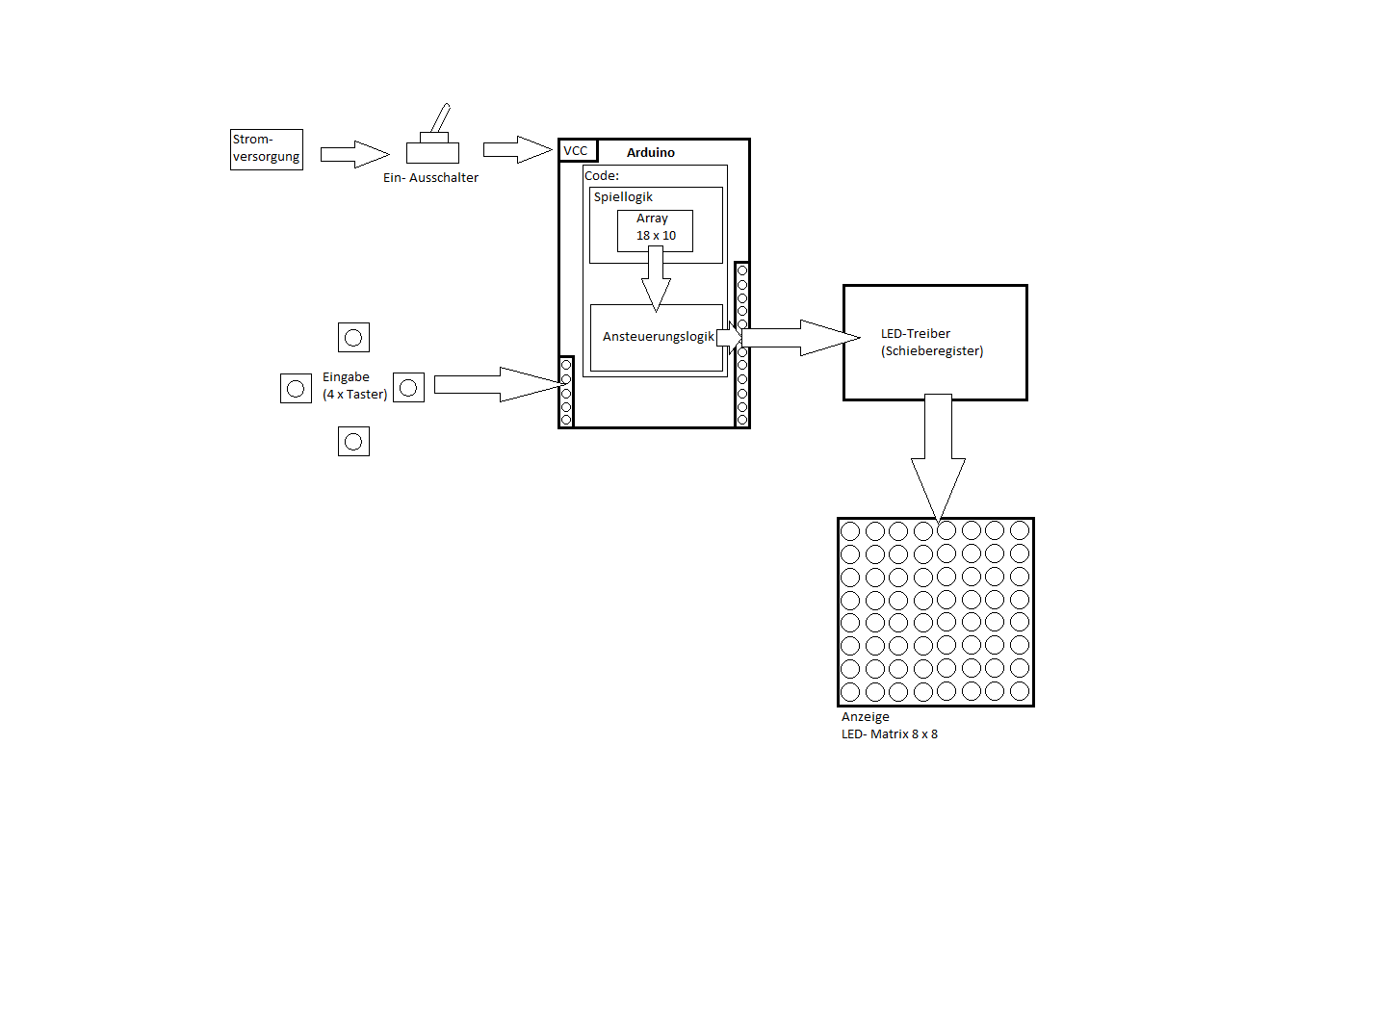
Bilder/SchnittstellenKonzept.png
