YodaCh96/Snake/Bilder/Widerstand.jpg

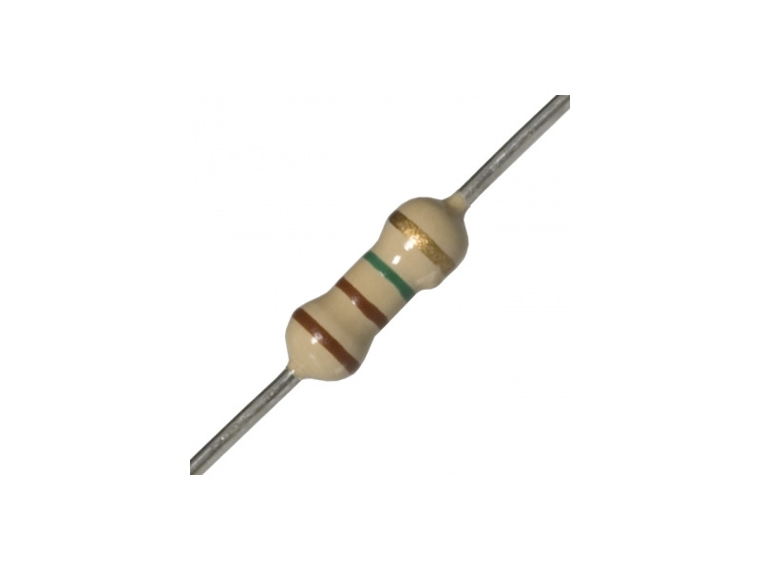
Bilder/Widerstand.jpg
