YodaCh96/Snake/Reprojekt/Bilder/Titelbild.jpg

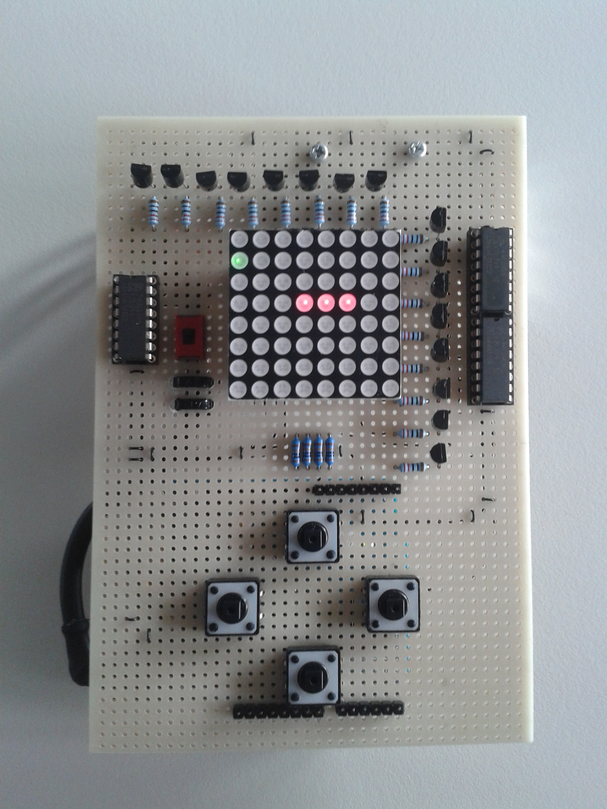
Reprojekt/Bilder/Titelbild.jpg
