YodaCh96/Snake/Reprojekt/src/snake_02/snake_02.ino

//#include <gfxfont.h>
//#include <Wire.h>
//#include <Adafruit_GFX.h>
//#include <Adafruit_LEDBackpack.h>
#include "pt.h"
#include "Matrix.h"



// Pinbelegung der Buttons für die Steuerung
#define PIN_BUTTON_RIGHT A1
#define PIN_BUTTON_LEFT A3
#define PIN_BUTTON_TOP A0
#define PIN_BUTTON_BOTTOM A2

// Länge und Breite des Spielfelds
#define MATRIX_HORIZONTAL_LENGTH 8
#define MATRIX_VERTICAL_LENGTH 8 
 
#define DIRECTION_TOP 0
#define DIRECTION_RIGHT 1
#define DIRECTION_BOTTOM 2
#define DIRECTION_LEFT 3

#define LED_ON 1
#define LED_OFF 0
 
// Prüft ob der Wert eine Schlange repräsentiert (im Spielfeld)
#define SNAKE(a) (a > 0)
 
int field[MATRIX_HORIZONTAL_LENGTH][MATRIX_VERTICAL_LENGTH] = { 0 };
int snakeHeadX;
int snakeHeadY;
 
static struct pt pt1, pt2;
static unsigned long timestampExc = 3;


int direction = DIRECTION_TOP; 
int snakeLength = 3;                             
unsigned long prevTime = 0;   
unsigned long delayTime = 200;     
 
int fruitX, fruitY;
unsigned long fruitPrevTime = 0;
unsigned long fruitBlinkTime = 200;
int fruitLed = LED_ON;
 
boolean gameOverShown = false;
boolean gameOver = false;





//Adafruit_8x8matrix matrix = Adafruit_8x8matrix();  
Matrix matrix = Matrix(); 




 
// Setup - wird einmal am Start des Programms aufgerufen
void setup() 
{
//Serial.begin(9600);
  
    // LED Matrix initialisieren
    randomSeed(analogRead(4));
    //matrix.begin(0x70);
   // matrix.setRotation(3);
 
    // Spiel initialisieren, Anfangsposition der Schlange zufällig setzen
    snakeHeadX = random(0, MATRIX_HORIZONTAL_LENGTH);
    snakeHeadY = random(0, MATRIX_VERTICAL_LENGTH);
    field[snakeHeadX][snakeHeadY] = snakeLength;
    
   // Serial.println("Head position");
   // Serial.println(snakeHeadX);
   // Serial.println(snakeHeadY);
       
    
    // Erste Frucht platzieren
    makeFruit();

    PT_INIT (&pt1);
    PT_INIT (&pt2);
    
}


static int protothread1 (struct pt *pt)
  {
    static unsigned long timestamp = 0;
    PT_BEGIN (pt);
    while (1)
    {
      timestamp = millis ();
      PT_WAIT_UNTIL (pt, millis () - timestamp > timestampExc);
       matrix.writeDisplay();
    }
    PT_END (pt);
  }

  static int protothread2 (struct pt *pt)
  {
    static unsigned long timestamp = 0;
    PT_BEGIN (pt);
    while (1)
    {
      timestamp = millis ();
      PT_WAIT_UNTIL (pt, millis () - timestamp > delayTime);
      loop2 ();
    }
    PT_END (pt);
  }





 
// Prüft ob der Button, der an buttonPin anliegt gedrückt ( > 500) wurde
boolean buttonClicked(int buttonPin) 
{
    return analogRead(buttonPin) > 500;
}
 
// Wird ständig aufgerufen, so lange das Programm läuft
void loop2()
{
  

  
    // ggf. Richtung der Schlange ändern
    checkButtons();


 
    // Game Loop verzögern, damit das Game nicht sofort vorrüber ist...
    unsigned long currentTime = millis();
    if (currentTime - prevTime >= delayTime) {
		//Ermittelt wie sich die Schlange bewegt
        nextstep();
		
        prevTime = currentTime;
    }



    
 
    // Spielfeld auf Matrix zeichnen
    draw();
}
 
// Prüft die Richtungstasten und setzt die Bewegungsrichtung der Schlange
// + Validierung um zu prüfen dass Schlange nicht "in sich" hereinläuft
void checkButtons()
{
    int currentDirection = direction;
    if (buttonClicked(PIN_BUTTON_LEFT) && currentDirection != DIRECTION_RIGHT) {
        direction = DIRECTION_LEFT;
       //  Serial.println("Button Left pressed");
    }
    else if (buttonClicked(PIN_BUTTON_RIGHT) && currentDirection != DIRECTION_LEFT) {
        direction = DIRECTION_RIGHT;
        // Serial.println("Button Right pressed");
    }
    else if (buttonClicked(PIN_BUTTON_TOP) && currentDirection != DIRECTION_BOTTOM) {
        direction = DIRECTION_TOP;
        // Serial.println("Button Top pressed");
    }
    else if (buttonClicked(PIN_BUTTON_BOTTOM) && currentDirection != DIRECTION_TOP) {
        direction = DIRECTION_BOTTOM;
       //  Serial.println("Button Bottom pressed");
    }
}
 
// Zeichnet das Spielfeld (Schlange + Frucht) auf der LED Matrix
void draw() 
{

   // Serial.println("Loop, draw");
 
  
    matrix.clear();

   
    // Wenn das Spiel noch läuft...
    if (!gameOver)
    {
        for (int x = 0; x < MATRIX_HORIZONTAL_LENGTH; x++)
        {
            for (int y = 0; y < MATRIX_VERTICAL_LENGTH; y++){
                //Serial.println("drawPixel");
                matrix.drawPixel(x, y, SNAKE(field[x][y]));
            }
        }
 
       // drawFruit();
         
        // überträgt die Änderungen an dem matrix Objekt auf die LED Matrix.
        //matrix.writeDisplay();


       // fieldArray2SerialMonitor(500);       
    }

    /*
    // Wenn Game Over...
    else
    {
        // Matrix konfigurieren sodass Schriftzug ausgegeben werden kann
        matrix.setTextSize(1);
        matrix.setTextWrap(false);
        matrix.setTextColor(LED_ON);
 
        // Schriftzug GAME OVER nur einmal anzeigen
        if (!gameOverShown)
        {
            for (int8_t x = 0; x >= -56; x--) {
                matrix.clear();
                matrix.setCursor(x, 0);
                matrix.print("GAME OVER");
                matrix.writeDisplay();
                delay(100);
            }
 
            gameOverShown = true;
        }
        // Anschließend immer wieder den erreichten Score anzeigen
        else {
            for (int8_t x = 0; x >= -56; x--) {
                matrix.clear();
                matrix.setCursor(x, 0);
                matrix.print("SCORE: ");
                matrix.print(snakeLength);
                matrix.writeDisplay();
                delay(100);
            }
        }
    }*/
}



 
// Zeichnet die Frucht auf die Matrix und implementiert das Blinken des Pixels
void drawFruit() 
{
    if (inPlayField(fruitX, fruitY)) {
        unsigned long currenttime = millis();
        if (currenttime - fruitPrevTime >= fruitBlinkTime) {
            fruitLed = (fruitLed == LED_ON) ? LED_OFF : LED_ON;
            fruitPrevTime = currenttime;
        }
      
        matrix.drawPixel(fruitX, fruitY, fruitLed);
    }
}
 
// Gibt zurück ob die angegebenen Koordinaten im Spielfeld liegen
boolean inPlayField(int x, int y) 
{
    return (x >= 0) && (x<MATRIX_HORIZONTAL_LENGTH) && (y >= 0) && (y<MATRIX_VERTICAL_LENGTH);
}
 
// Schlange verschieben, ggf. verlängern und feststellen ob Spiel vorbei ist
void nextstep() 
{
    int newX = snakeHeadX;
    int newY = snakeHeadY;
 
    // Basierend auf derzeitiger Richtung die Schlange verschieben
    switch (direction) {
        case DIRECTION_TOP:
            //newY--;
            newX--;
            break;
        case DIRECTION_RIGHT:
            //newX++;
            newY++;
            break;
        case DIRECTION_BOTTOM:
            //newY++;
            newX++;
            break;
        case DIRECTION_LEFT:
            //newX--;
            newY--;
            break;
    }
 
    // Wenn neue Position über die Grenzen der Matrix hinausragt, neue Position auf die andere Seite setzen
    if (newY >= MATRIX_VERTICAL_LENGTH)
        newY = 0;
    else if (newY < 0)
        newY = MATRIX_VERTICAL_LENGTH - 1;
 
    if (newX >= MATRIX_HORIZONTAL_LENGTH)
        newX = 0;
    else if (newX < 0)
        newX = MATRIX_HORIZONTAL_LENGTH - 1;
 
    // Wenn der Kopf ein Teil der Schlange berührt, war's das...
 /*   if (isPartOfSnake(newX, newY))
    {
        gameOver = true;
        delay(3000);
        return;
    }
    */
 
    // Wenn eine Frucht eingesammelt wird, Schlange erweitern und neue Frucht erstellen
    if ((newX == fruitX) && (newY == fruitY)) {
        snakeLength++;
        makeFruit();
    }
 
    // Spielfeld anpassen sodass Schlange verschoben wird
    for (int x = 0; x < MATRIX_HORIZONTAL_LENGTH; x++)
    {
        for (int y = 0; y < MATRIX_VERTICAL_LENGTH; y++)
        {
            int value = field[x][y];
            if (SNAKE(value))
                field[x][y] = value - 1;
        }
    }
 
    snakeHeadX = newX;
    snakeHeadY = newY;
    field[newX][newY] = snakeLength;
}
 
// Erstellt eine Frucht auf einer zufälligen Position innerhalb des Spielfelds
void makeFruit() 
{
    int x, y = 0;
 
    // Zufällige Position so generieren, dass sie nicht auf der Schlange liegt
    do {
        x = random(0, MATRIX_HORIZONTAL_LENGTH);
        y = random(0, MATRIX_VERTICAL_LENGTH);
    } while (isPartOfSnake(x, y));
 
    fruitX = x;
    fruitY = y;
}
 
// Prüft ob die übergebenen Koordinaten (der Punkt) ein Teil der Schlange ist
boolean isPartOfSnake(int x, int y)
{
    return SNAKE(field[x][y]);
}


int stopSerial = 0;
void fieldArray2SerialMonitor(int amount){
  
  
          //Field 8 * 8 ausgeben
         for (int z = 0; z < 8; z++)
          {
            Serial.println("");
            for (int t = 0; t < 8; t++)
            {
               Serial.print(field[z][t]);
            }
          }
          
          Serial.println("");
          stopSerial++;
          if(stopSerial == amount){
            exit(0);
           }

  }

void loop ()
  {
    protothread1 (&pt1);
    protothread2 (&pt2);
  } 
